nuniesmith/table-fan/electronics/pcb/gerber/bom.csv

Designator | Comment | Value | Footprint | JLCPCB Part #
U_A | MP1584EN-LF-Z | C15051 | C15051 | C15051
D_BST_A | 1N4148WS | C2128 | C2128 | C2128
CIN1_A | 10u | 10u | 1210_nosilkscreen | C138687
CIN2_A | 100n | 100n | 0805_nosilkscreen | C28233
RFREQ_A | 200k | 200k | 0805_nosilkscreen | C17539
CBST_A | 100n | 100n | 0805_nosilkscreen | C28233
L_A | SWPA6045S220MT | C83454 | C83454 | C83454
COUT1_A | 22u | 22u | 1210_nosilkscreen | C52306
COUT2_A | 100n | 100n | 0805_nosilkscreen | C28233
DC_A | SS34 | C115205 | C115205 | C115205
RFB2_A | 10k | 10k | 0805_nosilkscreen | C17414
RFB1_A | 140k | 140k | 0805_nosilkscreen | C17460
CCOMP_A | 220p | 220p | 0805_nosilkscreen | C107145
RCOMP_A | 68.1k | 68.1k | 0805_nosilkscreen | C17795
REN2_A | 24.9k | 24.9k | 0805_nosilkscreen | C17571
REN1_A | 100k | 100k | 0805_nosilkscreen | C149504
U_B | MP1584EN-LF-Z | C15051 | C15051 | C15051
CIN1_B | 10u | 10u | 1210_nosilkscreen | C138687
CIN2_B | 100n | 100n | 0805_nosilkscreen | C28233
RFREQ_B | 200k | 200k | 0805_nosilkscreen | C17539
CBST_B | 100n | 100n | 0805_nosilkscreen | C28233
L_B | SWPA6045S220MT | C83454 | C83454 | C83454
COUT1_B | 22u | 22u | 1210_nosilkscreen | C52306
COUT2_B | 100n | 100n | 0805_nosilkscreen | C28233
DC_B | SS34 | C115205 | C115205 | C115205
RFB2_B | 10k | 10k | 0805_nosilkscreen | C17414
RFB1_B | RC0805FR-0752K3L | 52.3k | 0805_nosilkscreen | C273887
CCOMP_B | 220p | 220p | 0805_nosilkscreen | C107145
RCOMP_B | 68.1k | 68.1k | 0805_nosilkscreen | C17795
REN2_B | 24.9k | 24.9k | 0805_nosilkscreen | C17571
REN1_B | 100k | 100k | 0805_nosilkscreen | C149504
J1_VIN | KF301-5.0-2P | C474881 | C474881 | C474881
Q_RP | AO3407A | C15155 | C15155 | C15155
D_GZ | BZT52C12S | C14643 | C14643 | C14643
R_GATE | 10k | 10k | 0805_nosilkscreen | C17414
C_BULK | UWT1V470MCL1GS | C87068 | C87068 | C87068
D_OR | SS34 | C115205 | C115205 | C115205
D_BENCH | SS34 | C115205 | C115205 | C115205
D_5V | SS14 | C2480 | C2480 | C2480
R_DIV1 | 100k | 100k | 0805_nosilkscreen | C149504
R_DIV2 | 22k | 22k | 0805_nosilkscreen | C17560
C_DIV | 100n | 100n | 0805_nosilkscreen | C28233
R_TACH | 10k | 10k | 0805_nosilkscreen | C17414
C_TACH | 1n | 1n | 0805_nosilkscreen | C46653
R_SCL | 4.7k | 4.7k | 0805_nosilkscreen | C17673
R_SDA | 4.7k | 4.7k | 0805_nosilkscreen | C17673
R_STAT | 10k | 10k | 0805_nosilkscreen | C17414
J2_FAN | 47053-1000 | C240840 | C240840 | C240840
J3_DIAL | B3B-XH-A(LF)(SN) | C144394 | C144394 | C144394
J4_OLED | B4B-XH-A(LF)(SN) | C144395 | C144395 | C144395
J5_BTN | B2B-XH-A(LF)(SN) | C158012 | C158012 | C158012
J6_CHG | B2B-XH-A(LF)(SN) | C158012 | C158012 | C158012
J7_BENCH | B2B-XH-A(LF)(SN) | C158012 | C158012 | C158012
