nuniesmith/table-fan/models/carrier_pcb.scad

// Generated by tools/check_pcb.py --write-scad from the PCB build
// (electronics/pcb/carrier-psu.tsx). Do not edit: change the board, rebuild,
// and run the tool again. Base coordinates: X across (+X = dial side), Z
// front to back, as in fan_housing.scad.

carrier_pcb_t = 1.6;
carrier_pcb_outline = [[18, 96.5], [18, 3.5], [58.5, 3.5], [58.5, 14], [43.5, 14], [43.5, 34], [58.5, 34], [58.5, 96.5]];
carrier_pcb_holes = [[21, 6.5], [55.5, 6.5], [40.5, 30.2], [55.7, 42.6], [47.5, 59.5], [55.5, 74], [21, 93.5], [55, 93.5]];         // M2, through the board into the plate's bosses
// each part's courtyard (X0, Z0, X1, Z1) and its height above the board
carrier_pcb_parts = [[25.25, 42.14, 27.15, 45.5, 1.35, "CBST_A"], [44.15, 42.14, 46.05, 45.5, 1.35, "CBST_B"], [29.885, 47.74, 31.785, 51.1, 1.35, "CCOMP_A"], [48.785, 47.74, 50.685, 51.1, 1.35, "CCOMP_B"], [28.555, 36.64, 33.115, 39.8, 2.7, "CIN1_A"], [47.455, 36.64, 52.015, 39.8, 2.7, "CIN1_B"], [26.25, 36.54, 28.15, 39.9, 1.35, "CIN2_A"], [45.15, 36.54, 47.05, 39.9, 1.35, "CIN2_B"], [18.42, 37.24, 22.98, 40.4, 2.7, "COUT1_A"], [37.32, 37.24, 41.88, 40.4, 2.7, "COUT1_B"], [19.02, 35.02, 22.38, 36.92, 1.35, "COUT2_A"], [37.92, 35.02, 41.28, 36.92, 1.35, "COUT2_B"], [44.1, 3.5, 52.9, 10.7, 6, "C_BULK"], [35.32, 59.05, 38.68, 60.95, 1.35, "C_DIV"], [28.85, 60.72, 30.75, 64.08, 1.35, "C_TACH"], [19.55, 47.62, 27.15, 50.82, 2.5, "DC_A"], [38.45, 47.62, 46.05, 50.82, 2.5, "DC_B"], [49.9, 83.55, 53.1, 91.15, 2.5, "D_5V"], [29.9, 12.35, 33.1, 19.95, 2.5, "D_BENCH"], [24.3, 35.92, 26.1, 40.32, 1.1, "D_BST_A"], [26.1, 63.9, 27.9, 68.3, 1.1, "D_CLAMP"], [26.4, 18.05, 29.6, 25.65, 2.5, "D_OR"], [34.9, 16.965, 42.9, 28.035, 10.5, "J1_VIN"], [18.1, 16.7, 25.5, 27.3, 17, "J2_FAN"], [18, 66.65, 25.2, 76.95, 15, "J3_DIAL"], [18, 77.35, 25.2, 90.15, 15, "J4_OLED"], [51.2, 62.6, 58.4, 70.4, 15, "J5_BTN"], [18, 58.1, 25.2, 65.9, 15, "J6_CHG"], [25.1, 3.9, 32.9, 11.1, 15, "J7_BENCH"], [18.3, 40.52, 24.9, 47.12, 4.5, "L_A"], [37.2, 40.52, 43.8, 47.12, 4.5, "L_B"], [29.885, 51.24, 31.785, 54.6, 1.35, "RCOMP_A"], [48.785, 51.24, 50.685, 54.6, 1.35, "RCOMP_B"], [25.65, 51.24, 27.55, 54.6, 1.35, "REN1_A"], [44.55, 51.24, 46.45, 54.6, 1.35, "REN1_B"], [27.65, 51.24, 29.55, 54.6, 1.35, "REN2_A"], [46.55, 51.24, 48.45, 54.6, 1.35, "REN2_B"], [35.05, 47.34, 36.95, 50.7, 1.35, "RFB1_A"], [53.95, 47.34, 55.85, 50.7, 1.35, "RFB1_B"], [33.05, 47.34, 34.95, 50.7, 1.35, "RFB2_A"], [51.95, 47.34, 53.85, 50.7, 1.35, "RFB2_B"], [33.65, 35.14, 35.55, 38.5, 1.35, "RFREQ_A"], [52.55, 35.14, 54.45, 38.5, 1.35, "RFREQ_B"], [31.82, 56.05, 35.18, 57.95, 1.35, "R_DIV1"], [35.32, 56.05, 38.68, 57.95, 1.35, "R_DIV2"], [26.05, 60.32, 27.95, 63.68, 1.35, "R_STAT"], [28.85, 64.32, 30.75, 67.68, 1.35, "R_TACH"], [27, 13, 29, 15, 0.2, "TP_12V"], [50.8, 76.5, 52.8, 78.5, 0.2, "TP_3V3"], [49.6, 93.6, 51.6, 95.6, 0.2, "TP_5V"], [50.8, 80, 52.8, 82, 0.2, "TP_GND"], [35.5, 28.7, 37.5, 30.7, 0.2, "TP_VIN"], [26, 70.5, 49, 96.5, 4.5, "U1"], [27.4, 40.02, 33, 47.62, 1.75, "U_A"], [46.3, 40.02, 51.9, 47.62, 1.75, "U_B"]];
