nuniesmith/table-fan/electronics/pcb/assembly.png

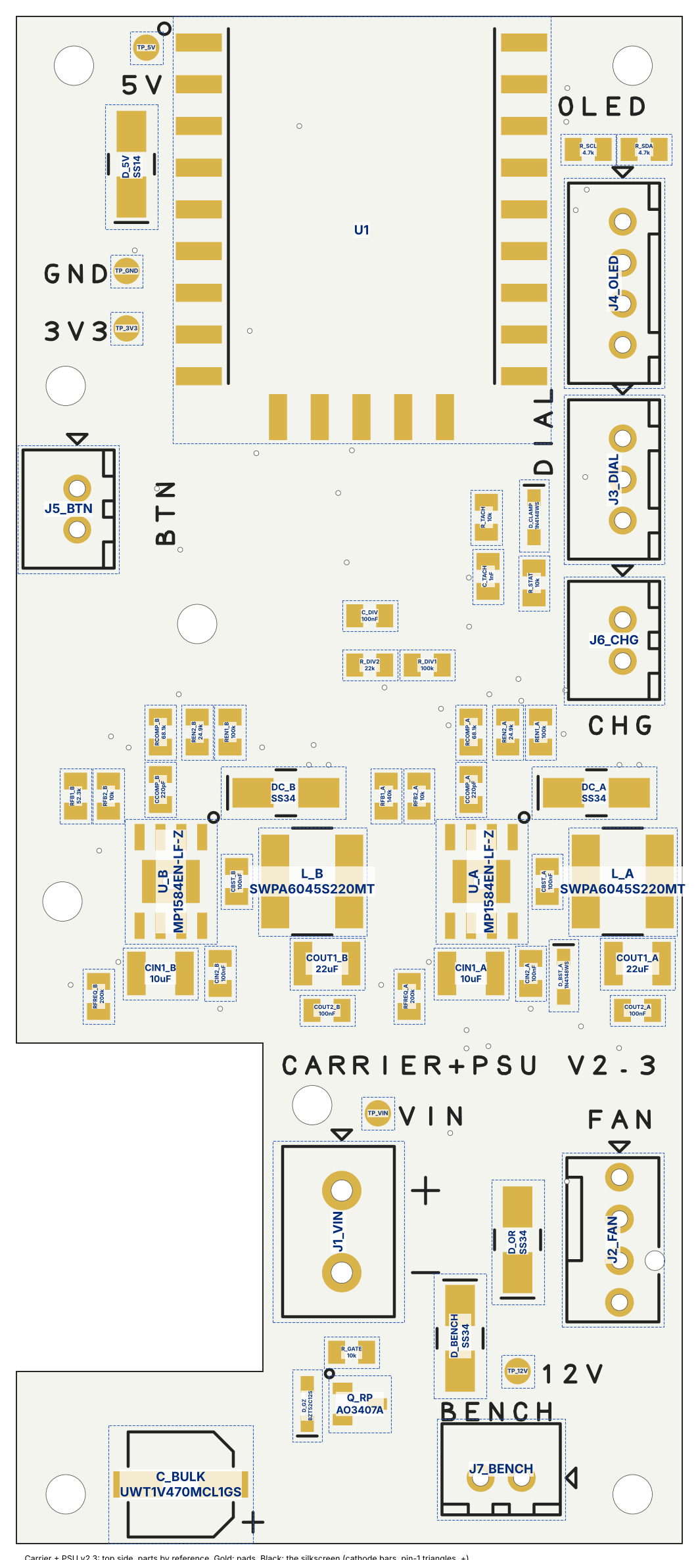
electronics/pcb/assembly.png
