nuniesmith/table-fan/slicing/ender3-neo-pla.ini

# PrusaSlicer config for the table fan on a Creality Ender-3 Neo, in PLA.
# Flattened from PrusaSlicer 2.8.1's bundled Creality profiles:
#   printer:  Creality Ender-3 Neo (0.4 mm nozzle)  (start G-code homes, then G29 probes the bed)
#   print:    0.20 mm NORMAL (0.4 mm nozzle) @CREALITY
#   filament: Generic PLA @CREALITY, at 205 C first layer and 200 C after (the owner's PLA), bed 60 C
# with this project's changes: perimeters 4, top/bottom 5, 25% gyroid, bridging perimeters detected, no supports, plain-text G-code.
# Import it in PrusaSlicer (File > Import > Import Config), or use tools/slice.py.
avoid_crossing_perimeters = 0
bed_shape = 3x3,228x3,228x228,3x228
bed_temperature = 60
before_layer_gcode = ;BEFORE_LAYER_CHANGE\nG92 E0\n;{layer_z}\n\n
between_objects_gcode = 
binary_gcode = 0
bottom_solid_layers = 5
bridge_acceleration = 250
bridge_angle = 0
bridge_fan_speed = 100
bridge_flow_ratio = 0.95
bridge_speed = 25
brim_width = 0
clip_multipart_objects = 1
complete_objects = 0
cooling = 1
default_acceleration = 500
default_filament_profile = "Generic PLA @CREALITY"
default_print_profile = "0.16 mm OPTIMAL (0.4 mm nozzle) @CREALITY"
deretract_speed = 40
disable_fan_first_layers = 1
dont_support_bridges = 1
elefant_foot_compensation = 0.1
end_gcode = {if max_layer_z < max_print_height}G1 Z{z_offset+min(max_layer_z+2, max_print_height)} F600 ; Move print head up{endif}\nG1 X5 Y{print_bed_max[1]*0.85} F{travel_speed*60} ; present print\n{if max_layer_z < max_print_height-10}G1 Z{z_offset+min(max_layer_z+70, max_print_height-10)} F600 ; Move print head further up{endif}\n{if max_layer_z < max_print_height*0.6}G1 Z{max_print_height*0.6} F600 ; Move print head further up{endif}\nM140 S0 ; turn off heatbed\nM104 S0 ; turn off temperature\nM107 ; turn off fan\nM84 X Y E ; disable motors
ensure_vertical_shell_thickness = 1
external_fill_pattern = rectilinear
external_perimeter_extrusion_width = 0.42
external_perimeter_speed = 25
external_perimeters_first = 0
extra_perimeters = 0
extruder_clearance_height = 25
extruder_clearance_radius = 55
extruder_colour = #FCE94F
extruder_offset = 0x0
extrusion_multiplier = 1
extrusion_width = 0.44
fan_always_on = 1
fan_below_layer_time = 100
filament_colour = #DDDDDD
filament_cost = 20
filament_density = 1.24
filament_diameter = 1.75
filament_max_volumetric_speed = 15
filament_notes = ""
filament_settings_id = ""
filament_soluble = 0
filament_type = PLA
filament_vendor = Generic
fill_angle = 45
fill_density = 25%
fill_pattern = gyroid
first_layer_bed_temperature = 60
first_layer_extrusion_width = 0.42
first_layer_height = 0.2
first_layer_speed = 20
first_layer_temperature = 205
gap_fill_speed = 30
gcode_comments = 0
gcode_flavor = marlin2
gcode_label_objects = 1
idle_temperature = 150
infill_every_layers = 1
infill_extruder = 1
infill_extrusion_width = 0.44
infill_first = 0
infill_only_where_needed = 0
infill_overlap = 23%
infill_speed = 50
interface_shells = 0
ironing_flowrate = 10%
ironing_spacing = 0.1
ironing_speed = 20
ironing_type = top
layer_gcode = ;AFTER_LAYER_CHANGE\n;{layer_z}
layer_height = 0.20
machine_limits_usage = emit_to_gcode
machine_max_acceleration_e = 5000
machine_max_acceleration_extruding = 500
machine_max_acceleration_retracting = 1000
machine_max_acceleration_travel = 500
machine_max_acceleration_x = 500
machine_max_acceleration_y = 500
machine_max_acceleration_z = 100
machine_max_feedrate_e = 60
machine_max_feedrate_x = 500
machine_max_feedrate_y = 500
machine_max_feedrate_z = 10
machine_max_jerk_e = 5
machine_max_jerk_x = 8
machine_max_jerk_y = 8
machine_max_jerk_z = 0.4
machine_min_extruding_rate = 0
machine_min_travel_rate = 0
max_fan_speed = 100
max_layer_height = 0.32
max_print_height = 250
max_print_speed = 100
max_volumetric_extrusion_rate_slope_negative = 0
max_volumetric_extrusion_rate_slope_positive = 0
max_volumetric_speed = 0
min_fan_speed = 100
min_layer_height = 0.06
min_print_speed = 15
min_skirt_length = 4
notes = 
nozzle_diameter = 0.4
only_retract_when_crossing_perimeters = 0
ooze_prevention = 0
output_filename_format = {input_filename_base}_{print_time}_{digits(layer_height,1,2)}mm_{temperature[0]}C_{filament_type[0]}_{printer_model}.gcode
overhangs = 1
pause_print_gcode = 
perimeter_extruder = 1
perimeter_extrusion_width = 0.44
perimeter_speed = 40
perimeters = 4
post_process = 
print_settings_id = 
printer_model = ENDER3NEO
printer_notes = Don't remove the following keywords! These keywords are used in the "compatible printer" condition of the print and filament profiles to link the particular print and filament profiles to this printer profile.\nPRINTER_VENDOR_CREALITY\nPRINTER_MODEL_ENDER3NEO\nPRINTER_HAS_BOWDEN
printer_settings_id = 
printer_technology = FFF
printer_variant = 0.4
raft_layers = 0
remaining_times = 0
resolution = 0
retract_before_travel = 2
retract_before_wipe = 70%
retract_layer_change = 1
retract_length = 5
retract_length_toolchange = 1
retract_lift = 0
retract_lift_above = 0.2
retract_lift_below = 0
retract_restart_extra = 0
retract_restart_extra_toolchange = 0
retract_speed = 60
seam_position = nearest
silent_mode = 0
single_extruder_multi_material = 0
single_extruder_multi_material_priming = 0
skirt_distance = 3
skirt_height = 2
skirts = 1
slowdown_below_layer_time = 20
small_perimeter_speed = 25
solid_infill_below_area = 0
solid_infill_every_layers = 0
solid_infill_extruder = 1
solid_infill_extrusion_width = 0.44
solid_infill_speed = 40
spiral_vase = 0
standby_temperature_delta = -5
start_gcode = G90 ; use absolute coordinates\nM83 ; extruder relative mode\nM104 S{is_nil(idle_temperature[0]) ? 150 : idle_temperature[0]} ; set temporary nozzle temp to prevent oozing during homing and auto bed leveling\nM140 S{first_layer_bed_temperature[0]} ; set final bed temp\nG4 S30 ; allow partial nozzle warmup\nG28 ; home all axis\nG29 ; auto bed levelling\nG1 Z50 F240\nG1 X2.0 Y10 F3000\nM104 S{first_layer_temperature[0]} ; set final nozzle temp\nM190 S{first_layer_bed_temperature[0]} ; wait for bed temp to stabilize\nM109 S{first_layer_temperature[0]} ; wait for nozzle temp to stabilize\nG1 Z0.28 F240\nG92 E0\nG1 X2.0 Y140 E10 F1500 ; prime the nozzle\nG1 X2.3 Y140 F5000\nG92 E0\nG1 X2.3 Y10 E10 F1200 ; prime the nozzle\nG92 E0
support_material = 0
support_material_angle = 0
support_material_buildplate_only = 0
support_material_contact_distance = 0.15
support_material_enforce_layers = 0
support_material_extruder = 0
support_material_extrusion_width = 0.36
support_material_interface_contact_loops = 0
support_material_interface_extruder = 0
support_material_interface_layers = 2
support_material_interface_spacing = 0.2
support_material_interface_speed = 100%
support_material_pattern = rectilinear
support_material_spacing = 1
support_material_speed = 40
support_material_synchronize_layers = 0
support_material_threshold = 40
support_material_with_sheath = 0
support_material_xy_spacing = 60%
temperature = 200
thin_walls = 0
toolchange_gcode = 
top_infill_extrusion_width = 0.40
top_solid_infill_speed = 30
top_solid_layers = 5
travel_speed = 150
use_firmware_retraction = 0
use_relative_e_distances = 1
use_volumetric_e = 0
variable_layer_height = 1
wipe = 1
wipe_tower = 0
wipe_tower_bridging = 10
wipe_tower_rotation_angle = 0
wipe_tower_width = 60
wipe_tower_x = 170
wipe_tower_y = 140
xy_size_compensation = 0
z_offset = 0
