nuniesmith/table-fan/(commit log)

2026-10-07 Initial design: OpenSCAD models for 120mm Noctua fan housing + removable M2 faceplate, full electronics BOM & wiring docs
    [faceplate.scad, fan_housing.scad]
2026-10-08 Update for 4S 18650 (14.8V): enlarge battery bay, revise electronics BOM & wiring for 4S + recommended 12V buck
    [faceplate.scad, fan_housing.scad]
2026-10-08 Lock in architecture: 4S 18650 + 12V buck + Pico manages charging, USB-C, power switch and fan PWM
2026-10-18 Design pass 2: two-level electronics bay, battery sled, dial switch, OLED pod, wiring diagram
2026-10-18 U-bail hang/prop bracket + USB-C to left wall
2026-10-18 Flush-folding bail, faceplate grille, screen button + sleep
2026-10-18 Firmware skeleton + dial GP12->GP27 fix (GP12 can't do ADC)
2026-10-18 Flush-folding bail, faceplate grille, screen button + sleep, firmware, dial GP27 fix
2026-10-18 Firmware: dial that settles, latched battery cutoff, crash-proof OLED
    Fixes the firmware findings of the 2026-10-18 design review:
    - Dial: the smoothing only stepped when the reading moved 800 counts, so
    the speed froze partway (a quick 0 -> 100% turn left it at 30%). It now
    smooths toward the latest reading every loop; screen wake has its own
    threshold and needs two readings in a row, so one noise spike can't
    light up the cab.
    - Low-voltage cutoff: averaged (16 samples + smoothing), needs 5 s below
    13.2 V, then latches until the pack is charged above 14.0 V. It used to
    chatter: the pack sags ~0.1 V under the fan and recovers when it stops.
    Battery % now reads 0 at the cutoff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
2026-10-18 Electronics: fuse, switched battery sense, STAT and USB-C checks
    From the 2026-10-18 design review.
    - 2 A fuse (or 1.5 A PTC) at BMS P+, before the dial switch; the charger
    lands on the pack side of it.
    - Battery divider moves to the switched VCC bus (on unswitched P+ it fed
    GP26 while the Zero was off) and becomes 100k/22k + 100 nF: 3.03 V at
    16.8 V, calibrated once with BATT_CAL.
    - Charger status pin: measure it before wiring GP13; 10k + clamp or an
    optocoupler if it exceeds 3.3 V.
    - Schottky into the Zero's 5V pin if that pin is tied to USB VBUS.
    - Charging rate on 5 V (~0.8 A, ~5 h), the USB-C socket's CC pull-downs,
    common-port BMS wiring, no soldering to cells, optional open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
2026-10-18 Redesign: battery base under the fan, open intake, working bail
    From the 2026-10-18 design review, which found four build blockers by
    measurement. All are fixed and now checked by tools/check_geometry.py.
    - Airflow: the fan sits in a 36 mm head, open front and back, with a
    grille on each face (the same faceplate, printed twice). Nothing else
    is behind it. A 16 mm slab used to cover 68% of the blades.
    - Battery: a base under the head runs back behind it and holds four
    cells side by side, axes front to back, in a lidded sled. The BMS sits
    on the lid, with the charger, both bucks and the Zero carrier beside
    it. The old sled was 24 mm wide for 65 mm cells.
    - Bail: the arms ride outsid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
2026-10-18 Docs: plastic-safe threadlocker against truck vibration
    From the review's truck-cab list: screws and pivots back out of
    printed parts under vibration.
    Claude-Session: https://claude.ai/code/session_01QXwijwfjbZ8s9A1tY5aTjK
2026-10-19 Firmware: whole dial travel, LED colour order, PWM on any MicroPython
    From the second review.
    - The dial's travel now maps linearly onto MIN_DUTY..100%. It used to
    clamp at MIN_DUTY, so with MIN_DUTY = 20 the bottom fifth of the dial
    did nothing. MIN_DUTY now defaults to 20, the NF-F12 iPPC-3000's
    minimum-speed duty; set 0 for a fan that slows further.
    - LED_SWAP_RG: some RP2040-Zero LEDs take RGB rather than GRB, so
    "running" would show red, the low-battery colour. The bench test now
    checks for it.
    - The PWM pin is set up step by step; older MicroPython takes no keyword
    arguments in the PWM constructor.
    - Bench test: measure the charger's status pin with the USB unplugged
    too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
2026-10-19 Print readiness: cable path, vents, stronger button and pot, test prints
    From the second review, before printing.
    - Fan cable: the fan sits 0.6 mm from the cavity walls, so its cable had
    no path from its corner to the floor slot; it would have been pinched
    under the fan. A groove across the cavity floor now leads it there.
    Its print-top edge is chamfered 45 deg.
    - The head prints rear face down. The corner ledges now run to the rear
    face, so they grow from the bed instead of bridging 28 mm up, and the
    fan nuts drop into hex pockets open on that face.
    - fan_clearance 0.4 -> 0.6: ASA's ~0.6% shrink takes 0.7 mm off a
    121 mm cavity.
    - Charger moved behind the head, under new vent s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
2026-10-19 check_geometry: export and check the test prints too
    `--stl stl` now writes all 13 STLs, the four test prints included, and
    each gets the manifold check.
    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
2026-10-20 Ender-3 Neo PLA slicing, and fixes for what the slicer flagged
    PrusaSlicer's stability check, slicing every plate for an Ender-3 Neo,
    flagged three parts. Each is fixed, and all seven plates now slice with
    no warnings:
    - Base "collapsing overhang": the ring round the pot bushing and the
    knob recess started as flat ledges in the upside-down print. Both are
    chamfered 45 deg now. The OLED wire opening's edge is peaked too: it
    was a 22 mm bridge in a 2.5 mm wall, hidden behind the pod.
    - Bottom plate "floating bridge anchors": the zip-tie tunnels' roofs
    are peaked at 45 deg.
    - The side-wall test printed face down, which made the knob recess a
    24 mm bridge. It now stands on its top edge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
2026-10-20 Bench test without a pack, a serial readout, and the PETG profile
    - Firmware: with nothing on the battery divider (USB power, on the
    bench) the battery read ~0 V, so the low-voltage cutoff stopped the
    fan 5 s into every bench test. Below 5 V there can't be a pack (the
    5 V buck can't run the Zero below ~5.5 V; the BMS disconnects at
    ~10 V), so the firmware now treats it as "no pack": no cutoff, and the
    screen says so. 3 new tests; 29 pass.
    - Firmware: a status line on USB serial every second (dial, duty, RPM,
    battery, charging, OLED missing), Thonny's readout for the bench test
    until the OLED arrives. SERIAL_STATUS_S = 0 turns it off.
    - slicing/ender3-neo-petg.ini: Creality's En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
2026-10-20 PLA at 205/200 C with bridge detection, matching the owner's profile
    The G-code that already prints well on this Neo (sliced with the same
    Creality Ender-3 Neo profile, filament "123-3D Jupiter PLA") runs at 205 C
    for the first layer and 200 C after, with "detect bridging perimeters"
    on. Match it: Creality's generic PLA was 210/205 with that off. All
    seven plates still slice with no warnings.
    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
2026-10-20 Build guide with a wiring cut list; PLA is the build material
    docs/BUILD.md takes the fan from printed parts to running, in order:
    - prepare the prints and set the inserts (180-200 C for PLA);
    - head and fan (the cable in the floor groove);
    - set the bucks first, then the Zero carrier's parts, then the pack
    (straps, the balance-lead order, foam, the BMS on the lid);
    - a harness cut list for every wire, worked out from the 3D layout
    with a 100 mm service loop on each plate-to-wall wire, so the
    bottom plate lowers beside the base still connected;
    - into the base, first power-up, firmware calibration (BATT_CAL,
    CHARGER_ACTIVE_LOW, LED_SWAP_RG, MIN_DUTY), close up and finish.
    The owner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
2026-10-20 OLED pod sized from the module's listing; its pin order and temp limit
    From the owner's listing for the 0.96" SSD1306 module:
    - 27.3 x 27.8 mm board, 21.74 x 10.86 mm active area;
    - header GND, VCC, SCL, SDA;
    - rated -20 to 60 C.
    The pod now fits that board, and its window frames the active area
    (24 x 13). The listing doesn't give the mounting holes; these boards put
    them 2 mm in from each edge, so the posts sit 23.3 x 23.8 apart. The
    docs say to check that on the real module before printing.
    The pin order goes into the BOM, the harness table and the wiring
    diagram, and the 60 C rating into the hot-cab note. The pod is plate 08
    in tools/slice.py: 1 h 05, ~7 g, no slicer warnings. The fit c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
2026-10-20 Deeper head to the base's back, and a bail that locks and folds flush
    The owner asked for the fan's back to be flush with the base, the bail to
    fold into the sides and hold set positions (raised notches or finger
    screws), and more room over the head for a truck hook.
    Head: 36 mm -> 100 mm deep. A full-width frame round the fan, then a duct to
    a rear grille printed as the head's first layers (the faceplate's pattern,
    so only the front faceplate prints now). The duct stands on the base, whose
    roof is its floor, so the base's vents open into it. Four corner columns
    run from the fan to the grille, outside the blades: the fan bolts into M3
    inserts in their front faces (nuts behind them would be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
2026-10-22 Add carrier+PSU PCB: tscircuit source, Gerber set, BOM and pick-and-place
2026-10-22 Carrier + PSU board v2: fit the base, meet fab rules, fix the bucks
    Rework the tscircuit board after the v1 review:
    - Outline cut round the dial pot and clear of the +X corner bosses;
    8 M2 holes, all off the plate's feet and vents.
    - JLCPCB 2-layer rules: 0.3/0.6 mm vias, >= 0.15 mm copper gaps,
    copper and NPTH clearances, 0.15+ mm silk, 1.19 mm text.
    - MP1584 exposed pad per the MPS land pattern (2.62 x 3.51) with a
    1.0 mm GND hole for soldering it from the back.
    - Each buck laid out round its SW pin: inductor, catch diode, BST,
    FB, COMP and EN drawn short in the source.
    - Parts no longer collide; XH headers spaced for their housings.
    - 47 uF 35 V bulk cap at J1; thermal reliefs on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
2026-10-22 Docs for the carrier + PSU board v2
    - electronics/pcb/README.md: rewritten for v2: what's on the board,
    connectors J1-J7, build/check/export, ordering, BOM, assembly
    (exposed pad from the back, polarity, header pin 1, the J1 bench
    test), mechanical, changes from v1, caveats.
    - Electronics doc, BUILD, PRINTING, DESIGN_OVERVIEW, README: the board
    replaces the perfboard, the MP1584 minis and the 1N5819s; a new wire
    cut list into the board's connectors; the charger on the sled lid;
    8x M2 x 6 and one tie bridge; first power-up starts with the board.
    - wiring_diagram.svg: the power and control half redrawn as one board
    block with its connectors.
    - The charger sits 2 mm further +X on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
2026-10-25 Carrier + PSU board v2.1: unmirror the board, clean the pours
    v2's Gerbers were the mirror image of the board the model fits: its
    frame mapped board +x to base +X, but the base seen from above (Y up,
    right-handed) has +X on the left. Made from those Gerbers, the notch
    would land on the sled's side and the holes miss the bosses.
    - New frame x = 42 - X, y = Z - 50. Every placement mirrored with each
    part the right way up; each buck block turned 180 deg whole. One hole
    moved (Z 47 -> 42.6) to clear the turned 5 V block.
    - Pours cleaned before export (check_pcb.py --clean-pours removes pour
    copper under 0.2 mm wide and loose pieces): v2 had 0.02 mm slivers.
    - Text 1.2 mm (was 0.96-0.99);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
2026-10-26 Carrier + PSU board v2.1: Zero footprint, buck loops and parts
    The reviews of v2.1 found:
    - The RP2040-Zero footprint (from v1) had 8 + 8 + 7 pads; the module has
    9 + 9 + 5. GP14 (the fan's tach) sat on no castellation. Now 9 + 9 + 5.
    - The bucks' input loops returned the long way round, as other nets cut
    the bottom pour: each now has a bottom GND plane and stitching vias.
    - Against the MP1584 datasheet: a bootstrap diode for buck A (72-91 %
    duty), 22 uH inductors (C83454), 50 V X7R input caps (C138687).
    - One plate hole moved to (55.7, 42.6) for a whole boss web; D_5V and
    TP_5V moved to the far end.
    - check_pcb.py checks slits, vias by pad openings, silk over holes, and
    paste; --c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
2026-10-26 Board v2.2: reverse-polarity FET, I2C pull-ups; M3x14, wider USB-C cutout
    Board:
    - J1's + now reaches VIN through a P-MOSFET (AO3407A, C15155), gate to
    GND through 10k and clamped by a 12 V zener (BZT52C12S, C14643): a pack
    wired backwards no longer takes out both MP1584s. C_BULK is after it.
    - 4.7k I2C pull-ups (C17673) above J4; J6, J3 and J4 moved 3.5 mm toward
    the front for them. The mounting holes are unchanged.
    - FAN_PWM and BATT_SENSE drawn on their v2.1 routes, VIN drawn from the
    FET to TP_VIN; two more GND stitching vias per buck.
    - check_pcb.py --clean cuts each pour clear of other nets' copper, fills
    acid-trap slits within any one net, and only where copper stays 0.15 mm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
2026-10-26 check_geometry: an OpenSCAD error is a failed render, not an empty one
    The screw-reach assert was global, so the self-test's shrunken fan cavity
    tripped it; OpenSCAD then aborted, and the script read the aborted render
    as empty, which a "clear" check passes. The assert now runs only in the
    join_screws check, and any "ERROR:" in OpenSCAD's log fails the render.
    Claude-Session: https://claude.ai/code/session_01M7z4yMbvEzEyBZyR8KR9n2
2026-10-26 Board v2.3: fan header's locating hole, real header outlines, soft-termination input caps
    - The Molex 47053-1000 has a locating peg under its housing (Molex: "PCB
    locator: yes"); v2-v2.2 had no hole for it, so the header wouldn't sit
    flat. J2 now has a 1.2 mm unplated hole for it, at KiCad's FanPinHeader
    position, so it only goes in one way round.
    - Each header's silk is now its real housing, off-centre on its pins, with
    the side that tells which way round: the JST XH headers' slotted wall
    (from KiCad's generated XH footprints) and the fan header's key wall.
    - CIN1: Murata GRJ32ER71H106KE11L (C710759), 50 V X7R 1210 with soft
    termination: across the pack, a flex crack must not sh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
